Kosik-Chris/HemoFlux/documents/atten.png

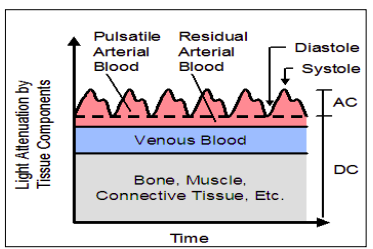
documents/atten.png
