Kosik-Chris/HemoFlux/documents/i2cMulti.jpeg

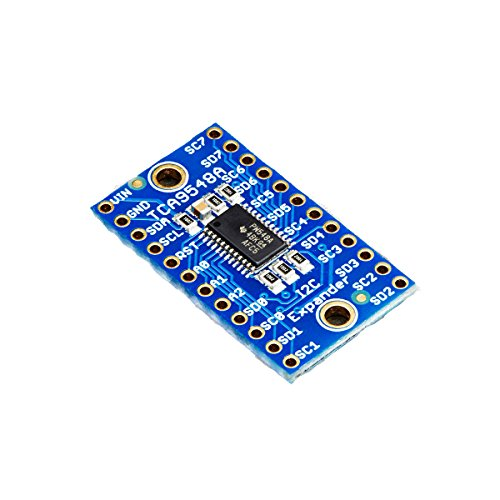
documents/i2cMulti.jpeg
