Kosik-Chris/HemoFlux/documents/imu.jpeg

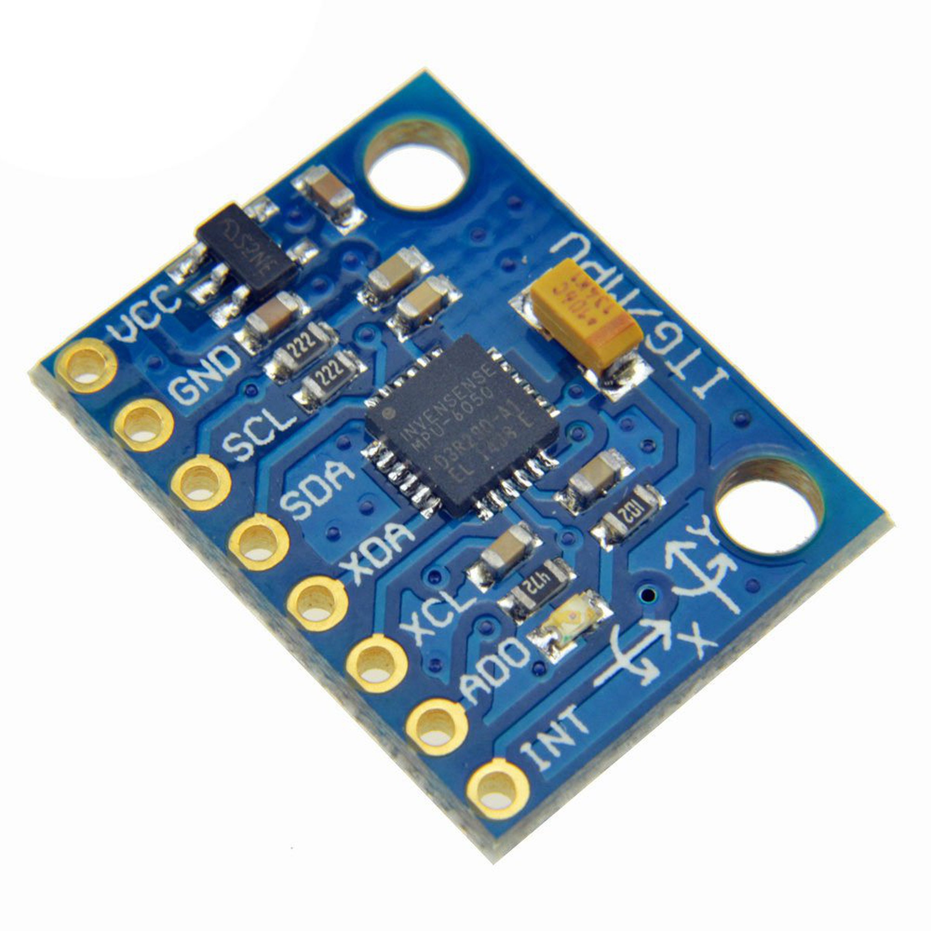
documents/imu.jpeg
