Kosik-Chris/HemoFlux/documents/Senior_Design_DataFlow.png

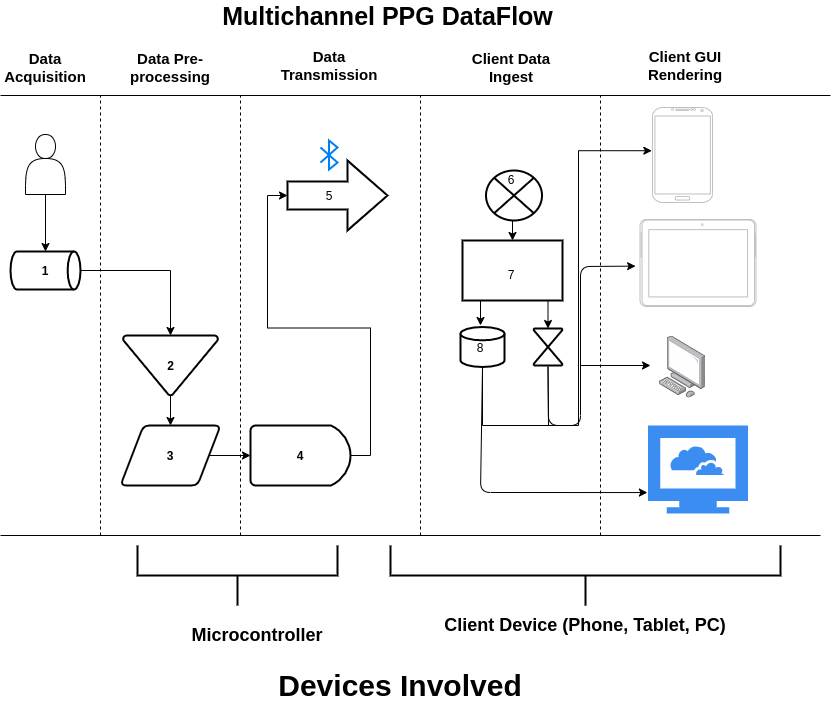
documents/Senior_Design_DataFlow.png
