Kosik-Chris/HemoFlux/documents/tileshop.jpeg

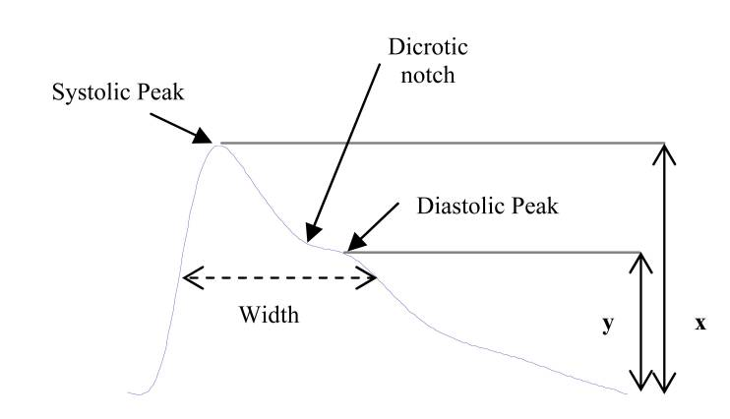
documents/tileshop.jpeg
