Kosik-Chris/HemoFlux/board/step/PPG_Proto_1.0.step

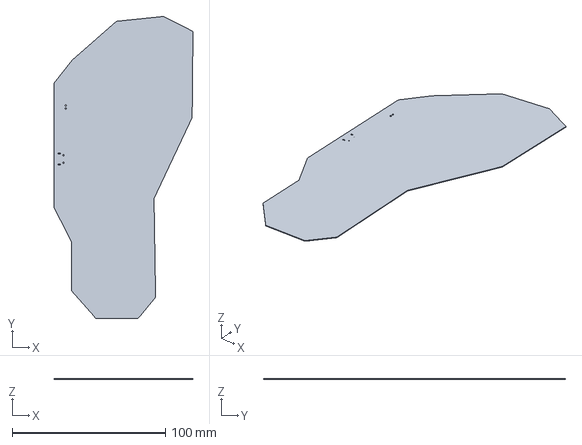
[picture p7: CAD file, 2020-03-08]
board/step/PPG_Proto_1.0.step
90.8 x 197.4 x 0.391 mm
