Kosik-Chris/HemoFlux/(list of files, cad)

Other CAD files:
board/dxf-source/PPG_Proto_1.0.dxf
