Kosik-Chris/HemoFlux/board/schematics/Schematic_HemoFlux-Module_HemoFlux-Module_20200316100258.pdf

## GND

## GND

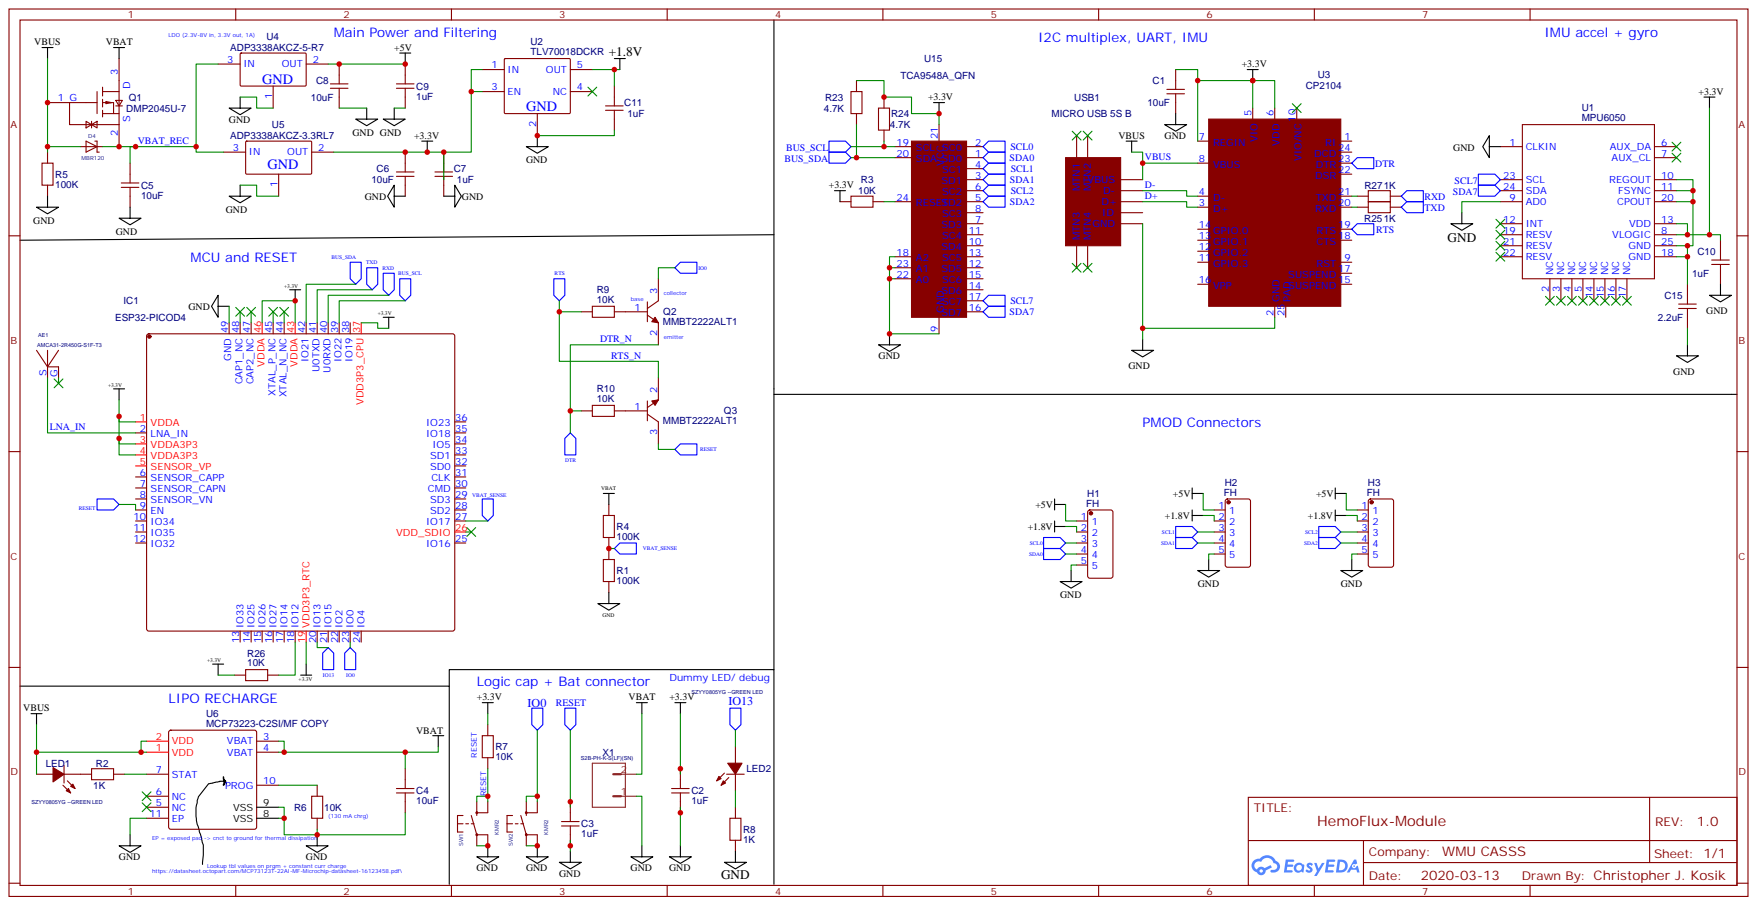
[picture p8: page 1]

Main Power and Filtering

IMU accel + gyro I2C multiplex, UART, IMU

Dummy LED/ debug Logic cap + Bat connector

EP = exposed pad -> cnct to ground for thermal dissipation

Lookup tbl values on prgm + constant curr charge

https://datasheet.octopart.com/MCP73123T-22AI-MF-Microchip-datasheet-16123458.pdf\

Drawn By: Christopher J. Kosik
