Kosik-Chris/HemoFlux/board/schematics/Schematic_PPG Foot Module.pdf

## GND

## GND

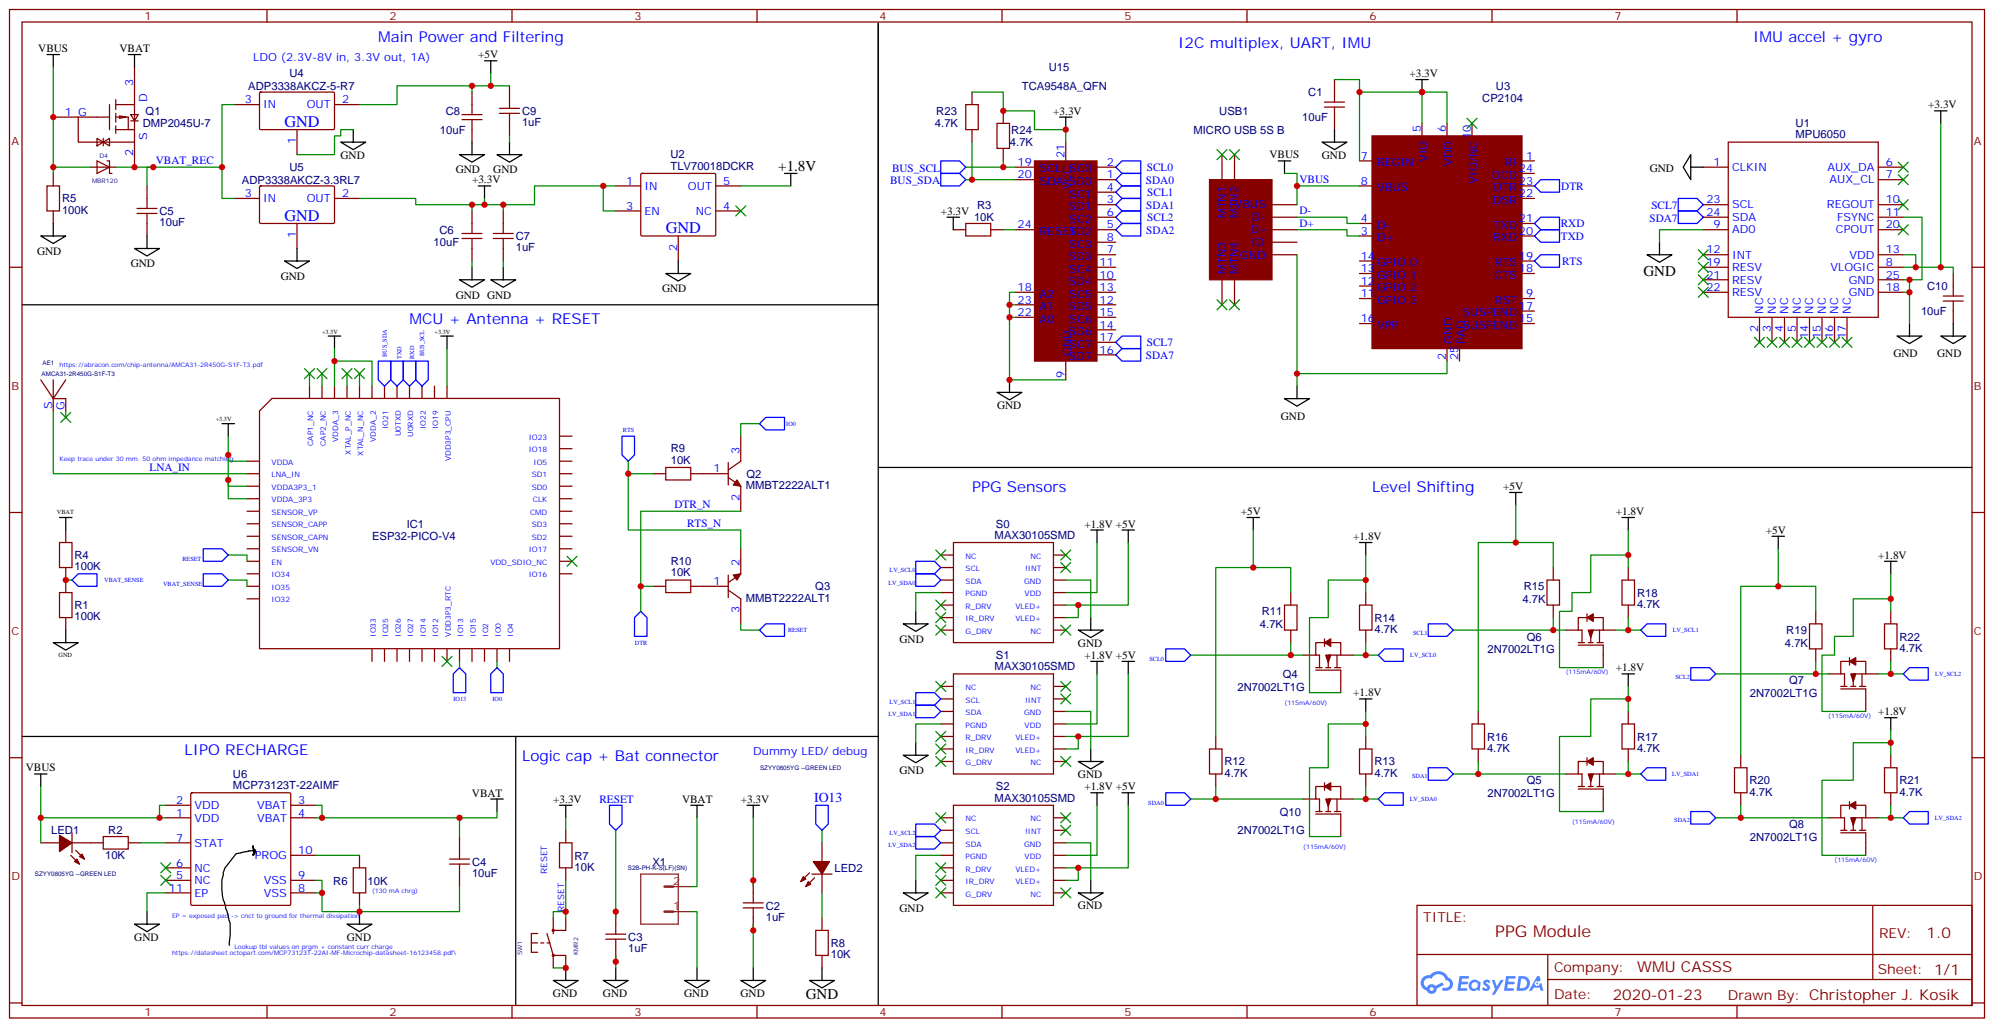
[picture p9: page 1]

Main Power and Filtering

IMU accel + gyro I2C multiplex, UART, IMU

https://abracon.com/chip-antenna/AMCA31-2R450G-S1F-T3.pdf
AMCA31-2R450G-S1F-T3

Keep trace under 30 mm. 50 ohm impedance matching

Logic cap + Bat connector RESET

EP = exposed pad -> cnct to ground for thermal dissipation

Lookup tbl values on prgm + constant curr charge

https://datasheet.octopart.com/MCP73123T-22AI-MF-Microchip-datasheet-16123458.pdf\

Drawn By: Christopher J. Kosik
