Kosik-Chris/HemoFlux/board/schematics/Schematic_HemoFlux-Node_HemoFlux-NODE_20200316100155.pdf

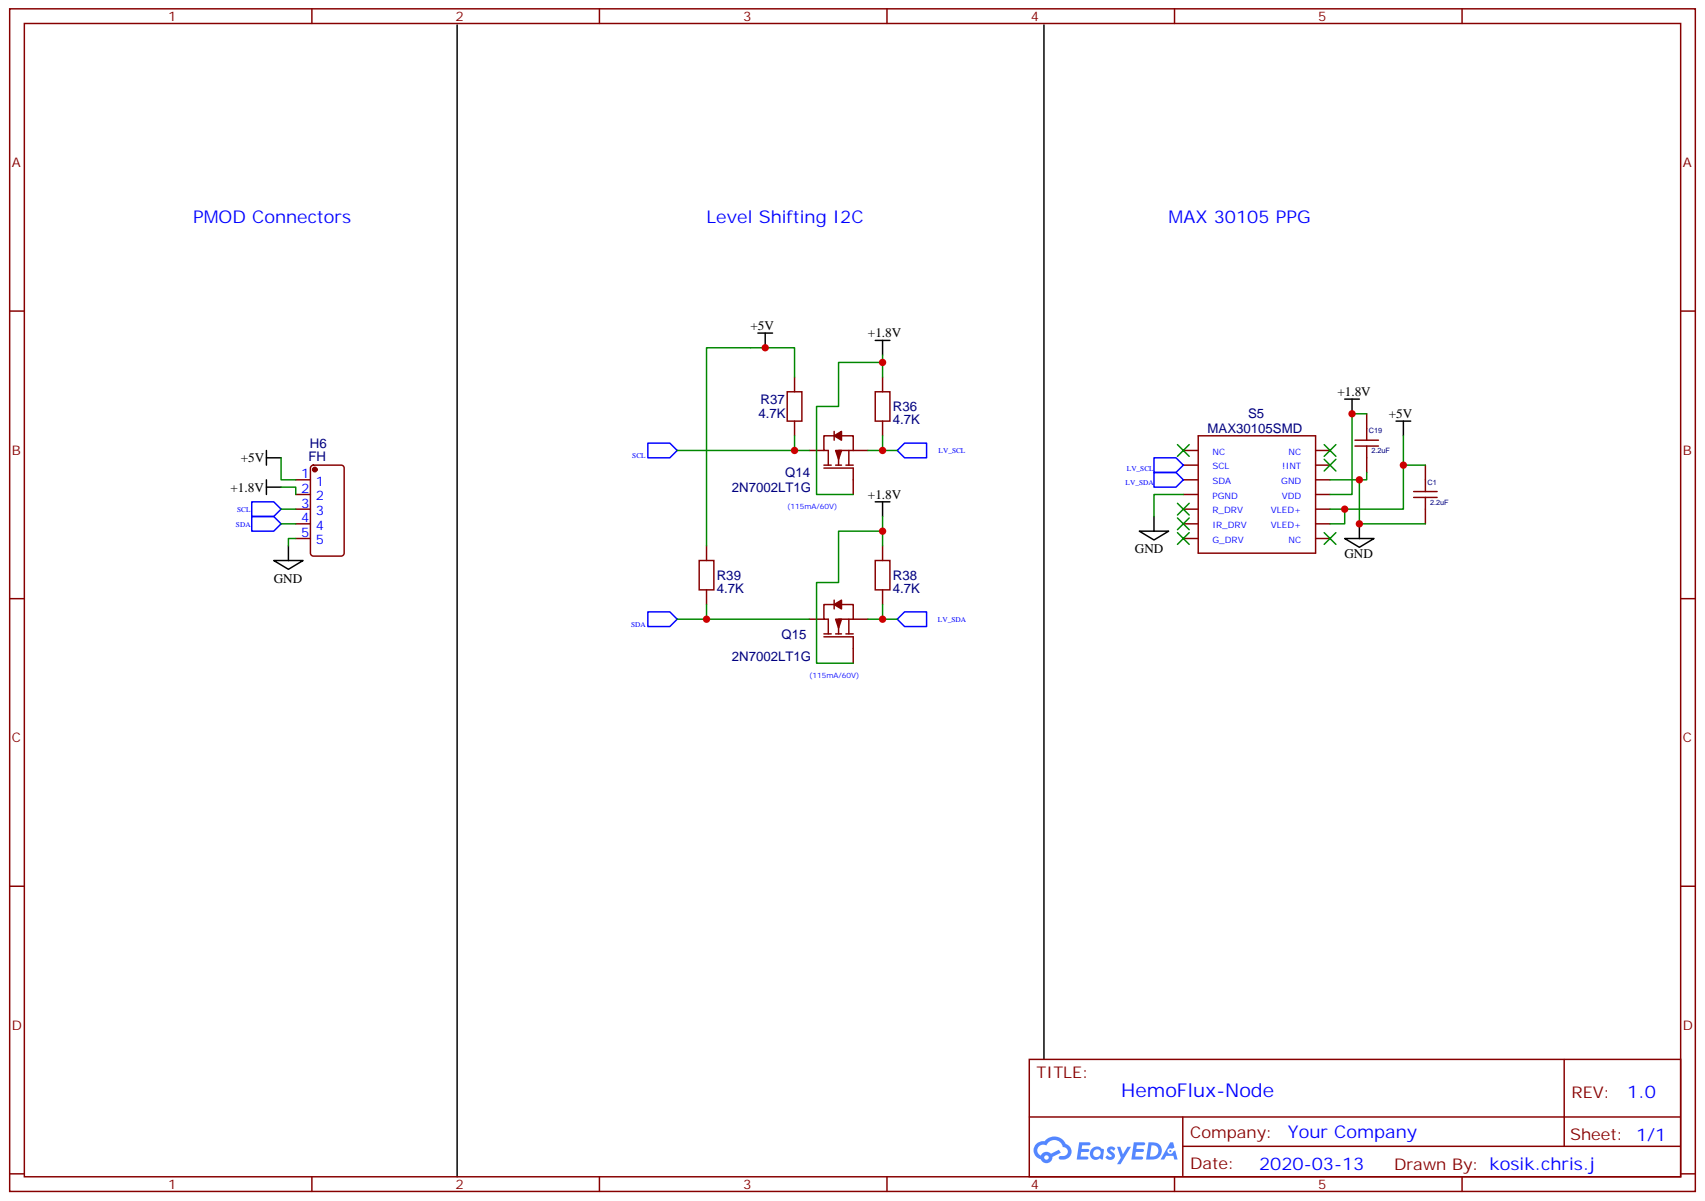
[picture p10: page 1]

Drawn By: kosik.chris.j
