Kosik-Chris/HemoFlux/board/pdf-source/PCB_PPG_Proto_1.0_20200304124513.pdf

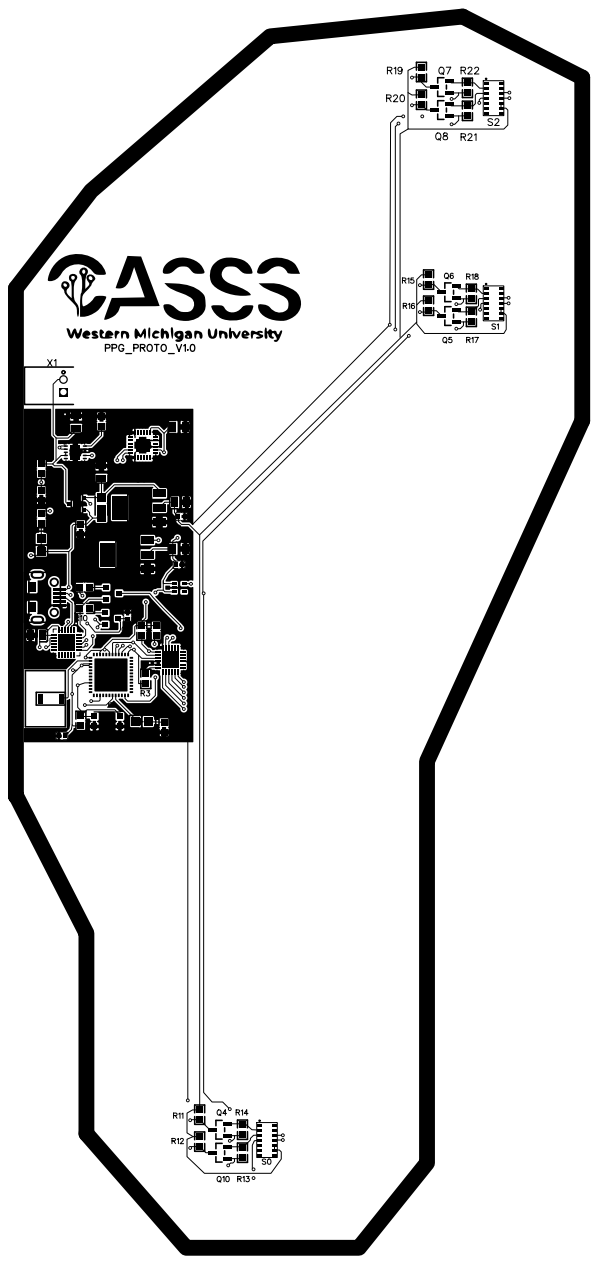
[picture p11: page 1]
