Kosik-Chris/HemoFlux/board/pdf-source/PCB_PPG_Proto_1.0_merged.pdf

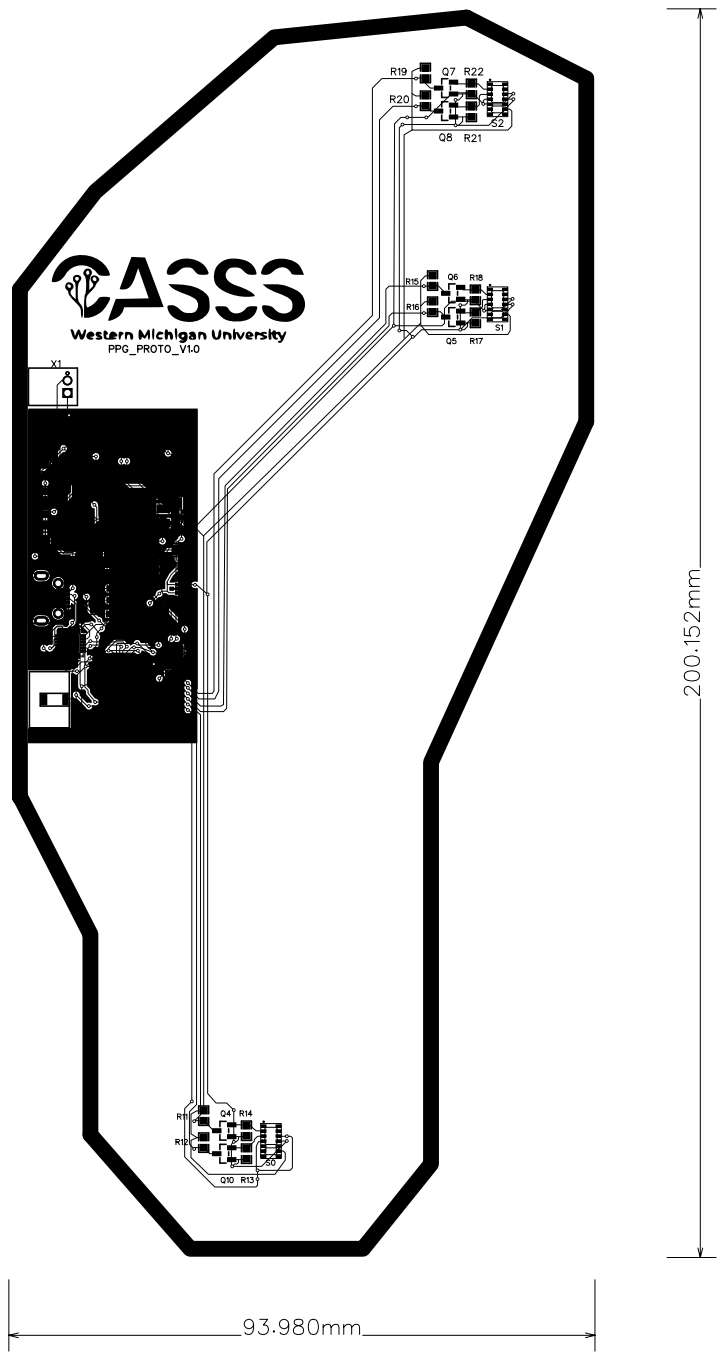
[picture p12: page 1]
