Kosik-Chris/HemoFlux/(list of files, drawings)

Other design files:
board/altium-source/PPG_Proto_1.0.pcbdoc
