Kosik-Chris/HemoFlux/(commit log)

2020-02-24 Swap over misc sketches into central repo
    [MAX30105_Plot.ino, PPG_SenSys.ino, TCA_FindDev.ino]
2020-03-06 Android Icon update
    [PPG_Proto_1.0.pcbdoc]
2020-03-08 Working on BLE ingest
    [PPG_Proto_1.0.step]
2020-03-09 Firmware + BLE tx updates. Removed RTOS from PPG sys as unstable/ dropping of tasks. PPG_SYS.ino is main firmware file. App in basic receive functionality with UI rendering for 1 characteristic
    [PPG_Proto_1.0.dxf]
2020-03-09 Added battery tx and changed pin to ADC1 GPIO 34
2020-03-18 New Board design. Updated documentation.
    [HemoFlux.kicad_pcb, HemoFlux.sch, PPGFootModule.sch, PPG_Proto_1.0.kicad_pcb]
2020-03-19 Mobile app render single line graph value. Determined timing sensitivities for UI response requires lower frequency update rates to notifications. Active firmware is HemoFlux, not PPG RTOS. TODO: upd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
2020-03-20 variable ppg support. IMU in progress. Exception handling
2020-03-23 Firmware updates: Added IMU calibration, BLE broadcasting. Updated channel BLE services to single channel service vs. service for each wavelength TODO: fix endianess of the BLE transmission (backward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
    [HemoFlux.ino, HemoFlux_config.h]
2020-03-26 HR start + more imu calibration IMU calibrates consistenyl below 13s. Acceptable for now
2020-03-28 IMU state handling updated. quick and dirty
2020-03-31 Single PPG, 3 channel real time graph update. Raw data values respond well at around 33ms max update (throughput as well). JSON file updated with uC header system variables. TODO: huge incoming UI/UX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
2020-04-02 Fixed X axis gooberness - FPS issues if trying massive moving timeline. Still internally recorded for Db/ csv etc. In progress: react-navigation/native upgrade from current stack navigation. UI overh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
    [HemoFlux.ino, HemoFlux_config.h]
2020-04-06 IOS update, swift 5 switch
2020-04-08 UI updates. Added info screen, Fixed BLE mounting error. TODO(in order): get IOS working Finalize the Help me/ info screens Finalize the session how to screen (when not started)\ Implement device sto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
    [HemoFlux.ino, HemoFlux_config.h]
2020-04-09 IOS officially working! Major performance limitations compared to android Note 9 vs I6. JS thread looks overburdened by Array shifting.
